MishoMish/Maestro/print/maestro_case/plates/1_ARDUINO_CASE_black.3mf

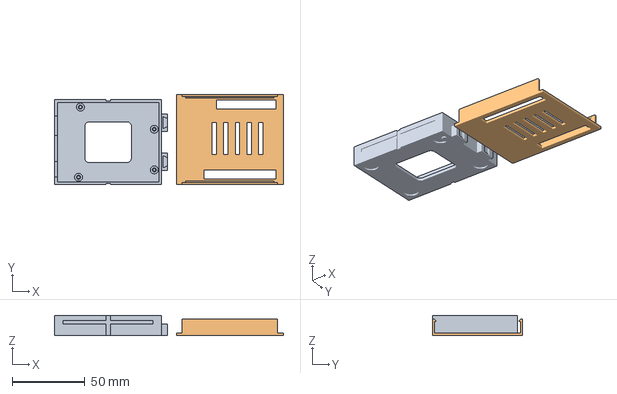
[picture p1: CAD file, 2026-11-06]
print/maestro_case/plates/1_ARDUINO_CASE_black.3mf
157.6 x 62.2 x 14.0 mm
reusable_uno_tray
reusable_uno_lid
