MishoMish/Maestro/print/maestro_case/stl/1_arduino_case/reusable_uno_lid.stl

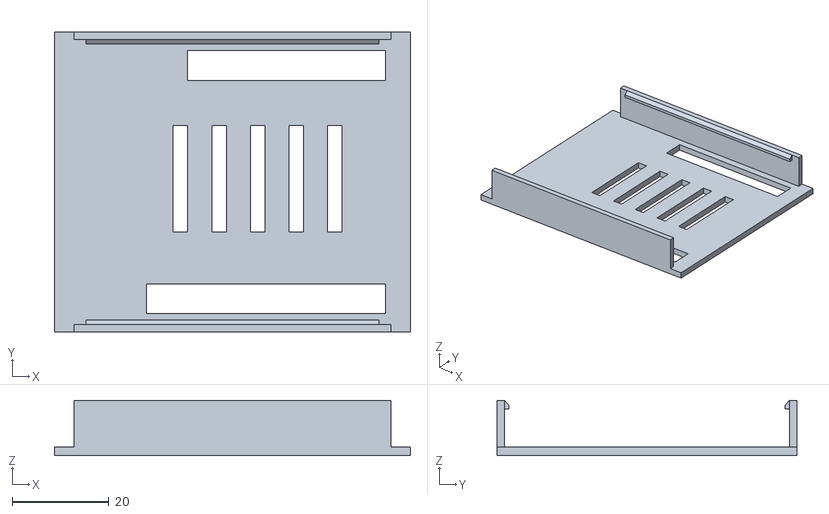
[picture p2: CAD file, 2026-11-06]
print/maestro_case/stl/1_arduino_case/reusable_uno_lid.stl
73.8 x 62.2 x 11.4
