MishoMish/Maestro/print/maestro_case/stl/2_breadboard_case/maestro_keybed_tray.stl

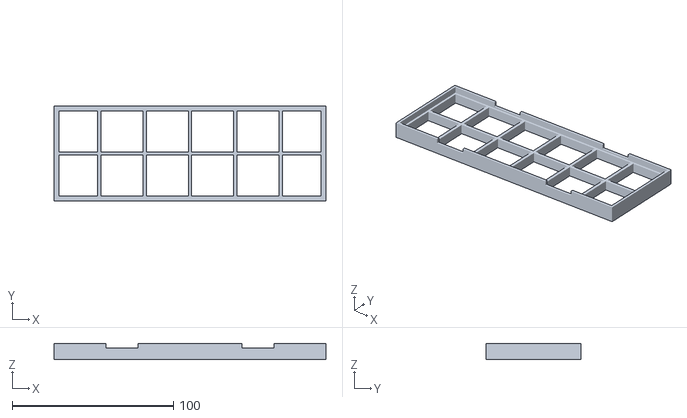
[picture p3: CAD file, 2026-11-06]
print/maestro_case/stl/2_breadboard_case/maestro_keybed_tray.stl
168.8 x 58.8 x 10.2
