MishoMish/Maestro/print/maestro_case/stl/3_maestro/maestro_knob.stl

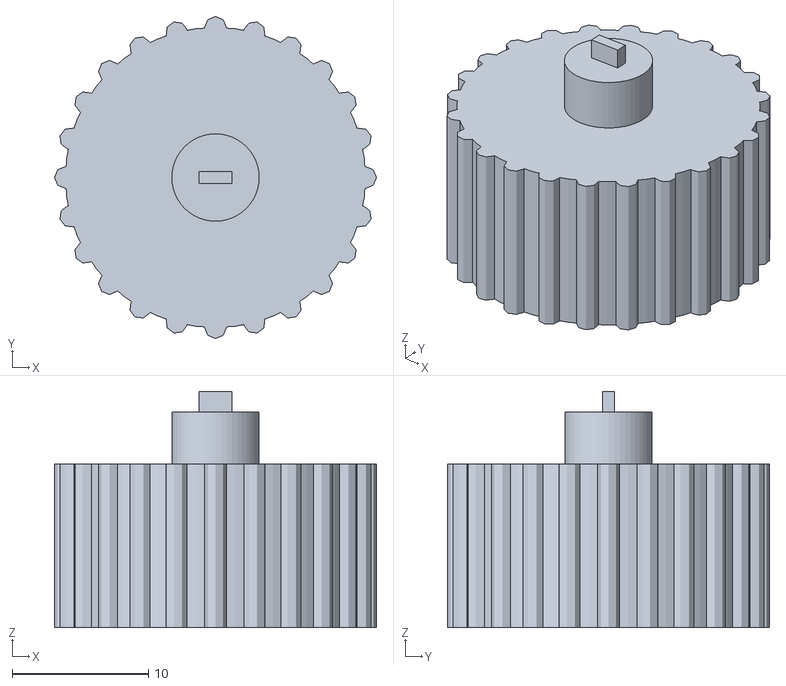
[picture p4: CAD file, 2026-11-06]
print/maestro_case/stl/3_maestro/maestro_knob.stl
23.6 x 23.6 x 17.3
