MishoMish/Maestro/print/maestro_case/plates/3_MAESTRO_BOX_black.3mf

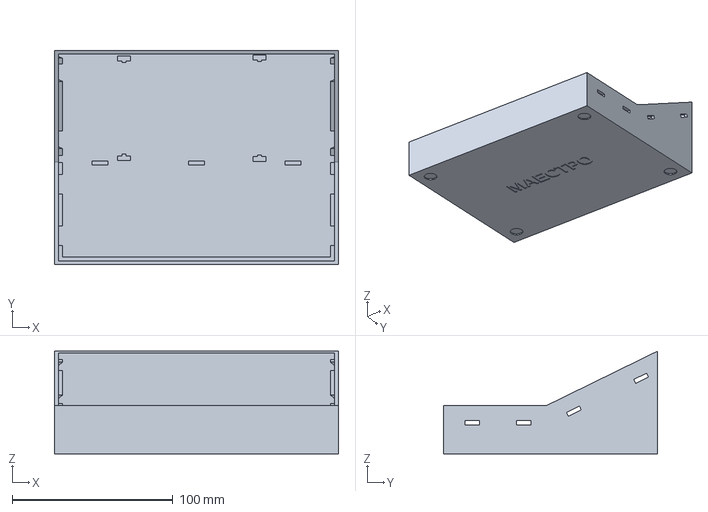
[picture p5: CAD file, 2026-11-06]
print/maestro_case/plates/3_MAESTRO_BOX_black.3mf
176.8 x 133.4 x 64.0 mm
