MishoMish/Maestro/print/maestro_case/stl/1_arduino_case/reusable_uno_tray.stl

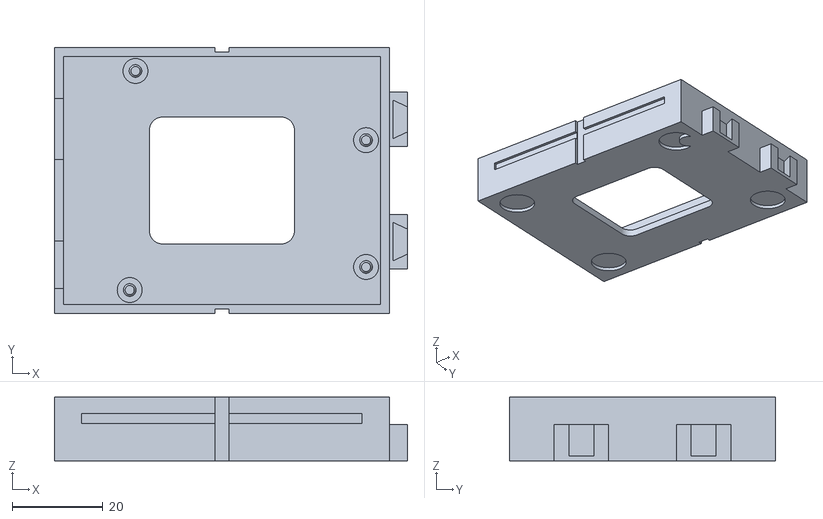
[picture p6: CAD file, 2026-11-06]
print/maestro_case/stl/1_arduino_case/reusable_uno_tray.stl
77.8 x 58.5 x 14.0
