MishoMish/Maestro/print/maestro_case/stl/2_breadboard_case/reusable_bb_tray.stl

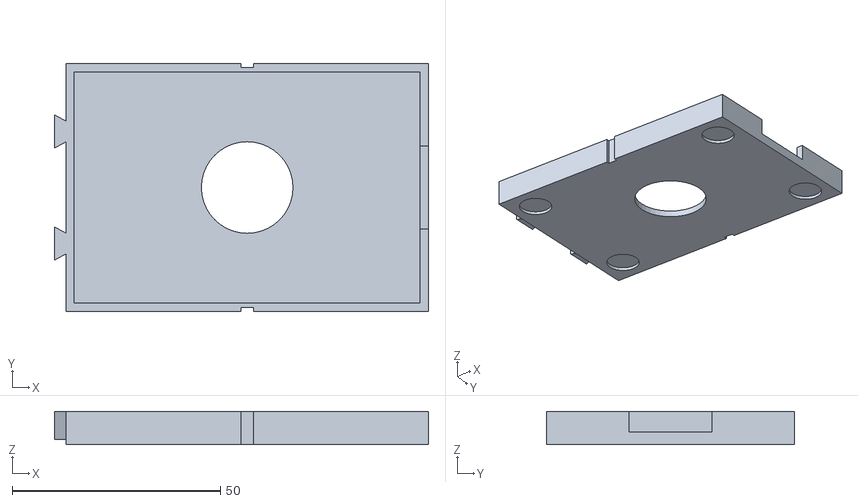
[picture p7: CAD file, 2026-11-06]
print/maestro_case/stl/2_breadboard_case/reusable_bb_tray.stl
89.8 x 59.6 x 8.00
