MishoMish/Maestro/print/maestro_case/stl/3_maestro/maestro_test_key.stl

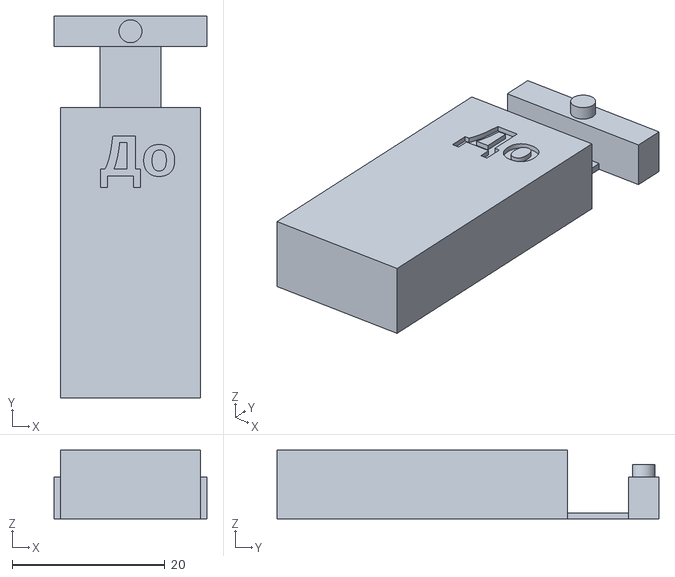
[picture p8: CAD file, 2026-11-06]
print/maestro_case/stl/3_maestro/maestro_test_key.stl
20.0 x 50.0 x 9.00
