MishoMish/Maestro/print/maestro_case/plates/2_BREADBOARD_CASES_black.3mf

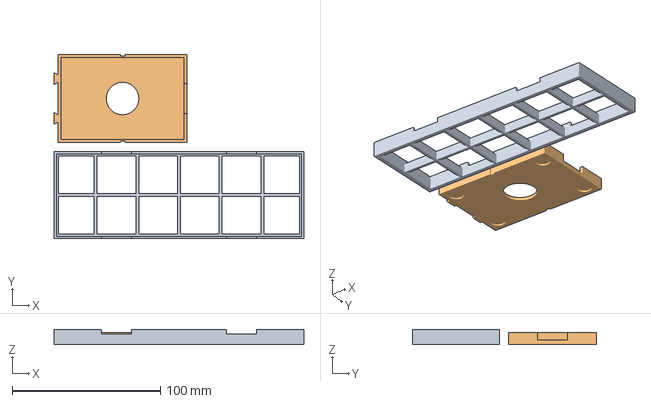
[picture p9: CAD file, 2026-11-06]
print/maestro_case/plates/2_BREADBOARD_CASES_black.3mf
168.8 x 124.4 x 10.2 mm
maestro_keybed_tray
reusable_bb_tray
