MishoMish/Maestro/print/maestro_case/stl/3_maestro/maestro_test_key_plate.stl

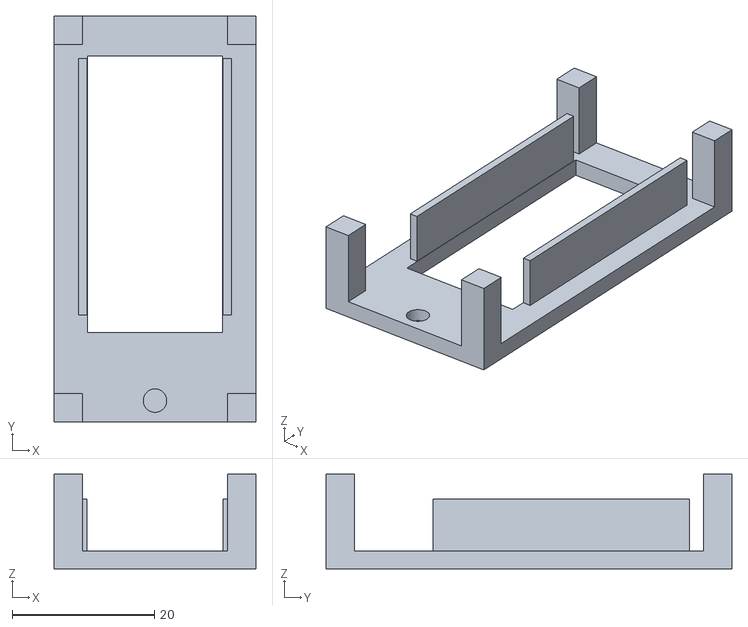
[picture p10: CAD file, 2026-11-06]
print/maestro_case/stl/3_maestro/maestro_test_key_plate.stl
28.3 x 57.0 x 13.3
