MishoMish/Maestro/print/maestro_case/plates/4_MAESTRO_PLATES_black.3mf

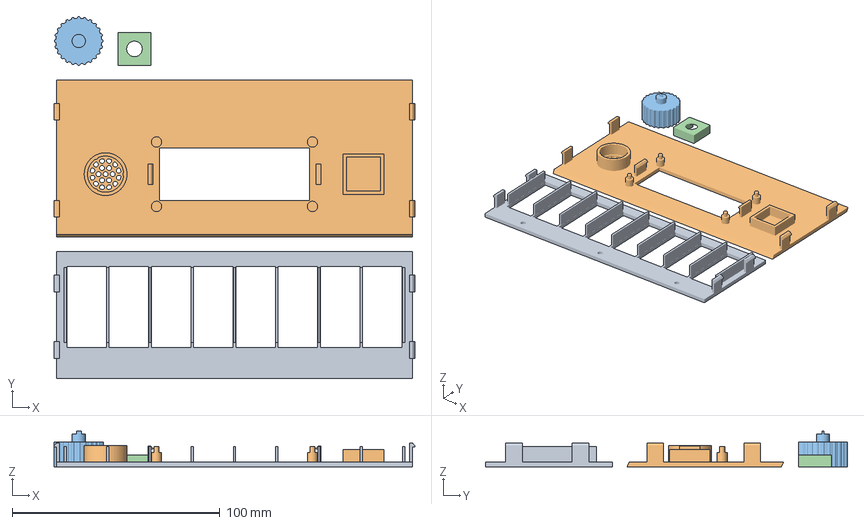
[picture p11: CAD file, 2026-11-06]
print/maestro_case/plates/4_MAESTRO_PLATES_black.3mf
173.4 x 174.1 x 17.3 mm
maestro_deck_plate
maestro_panel
maestro_knob
maestro_pot_holder
