MishoMish/Maestro/print/maestro_case/plates/0_TESTS_black.3mf

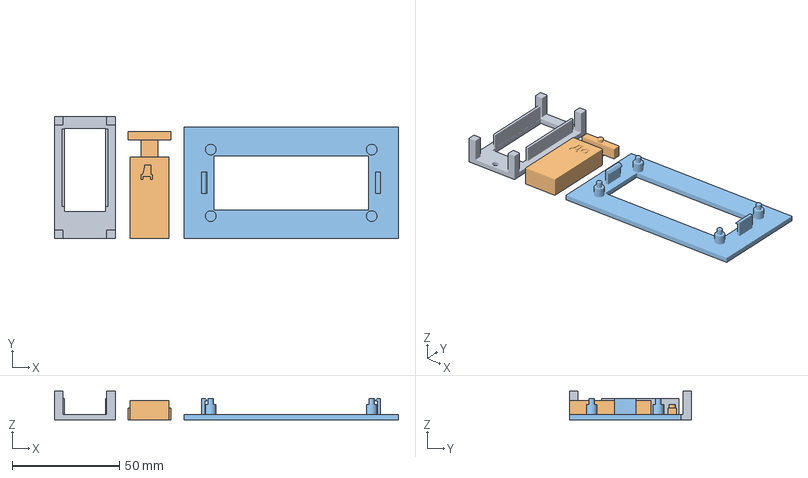
[picture p12: CAD file, 2026-11-06]
print/maestro_case/plates/0_TESTS_black.3mf
160.3 x 57.0 x 13.3 mm
maestro_test_key_plate
maestro_test_key
maestro_test_lcd
