MishoMish/Maestro/print/maestro_case/stl/3_maestro/maestro_key_comb.stl

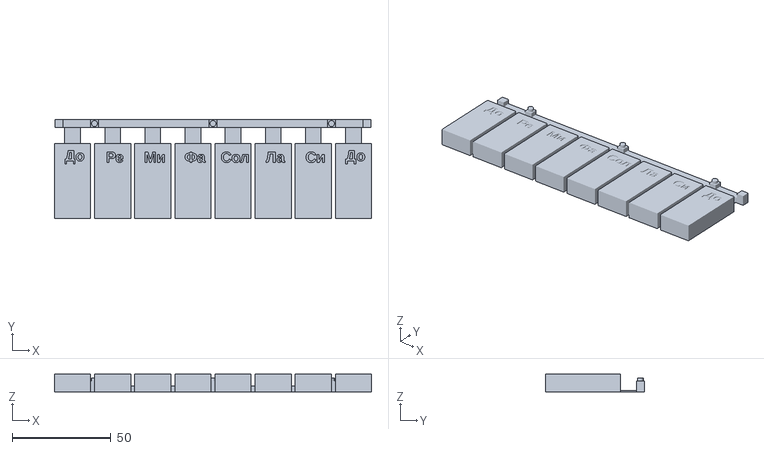
[picture p13: CAD file, 2026-11-06]
print/maestro_case/stl/3_maestro/maestro_key_comb.stl
160.5 x 50.0 x 9.00
