MishoMish/Maestro/print/maestro_case/stl/3_maestro/maestro_panel.stl

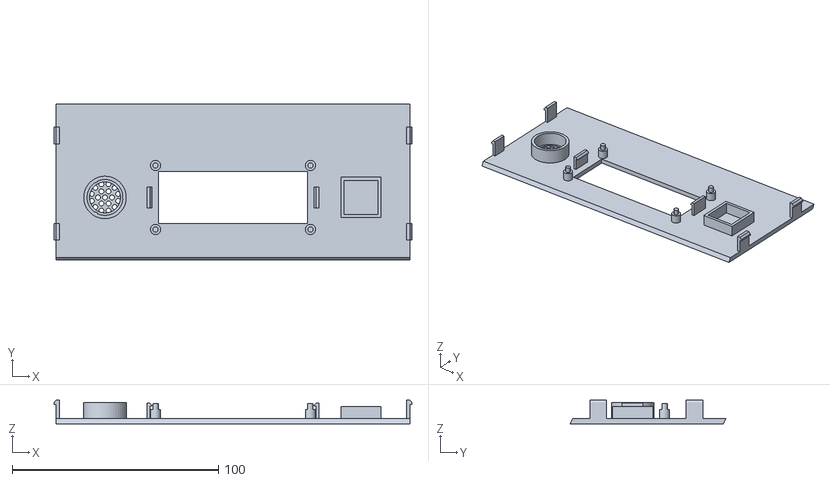
[picture p14: CAD file, 2026-11-06]
print/maestro_case/stl/3_maestro/maestro_panel.stl
173.4 x 75.5 x 11.5
