MishoMish/Maestro/print/maestro_case/stl/3_maestro/maestro_test_lcd.stl

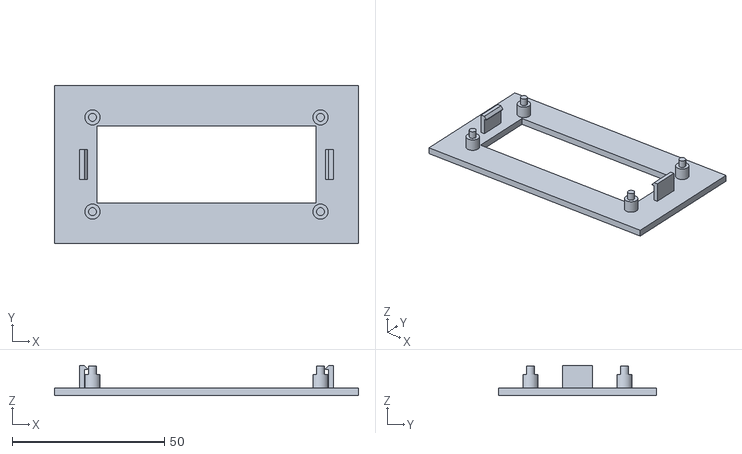
[picture p15: CAD file, 2026-11-06]
print/maestro_case/stl/3_maestro/maestro_test_lcd.stl
100.0 x 52.0 x 10.0
