MishoMish/Maestro/print/maestro_case/stl/3_maestro/maestro_deck_plate.stl

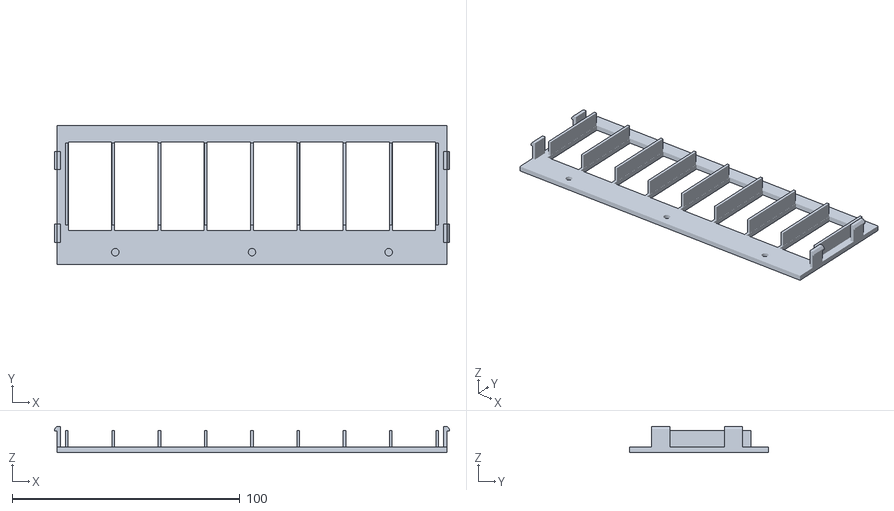
[picture p16: CAD file, 2026-11-06]
print/maestro_case/stl/3_maestro/maestro_deck_plate.stl
173.4 x 61.0 x 11.5
