MishoMish/Maestro/print/maestro_case/stl/3_maestro/maestro_pot_holder.stl

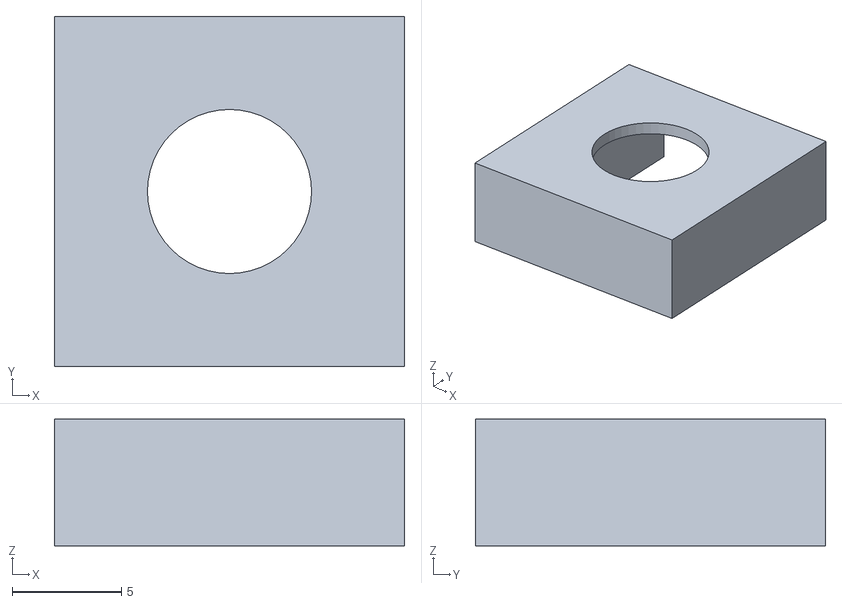
[picture p17: CAD file, 2026-11-06]
print/maestro_case/stl/3_maestro/maestro_pot_holder.stl
16.0 x 16.0 x 5.80
