MishoMish/Maestro/(list of files, cad)

Other CAD files:
print/maestro_case/stl/3_maestro/maestro_box.stl
print/maestro_case/plates/5_MAESTRO_KEYS_white.3mf
