MishoMish/Maestro/print/maestro_case/preview/assembled.png

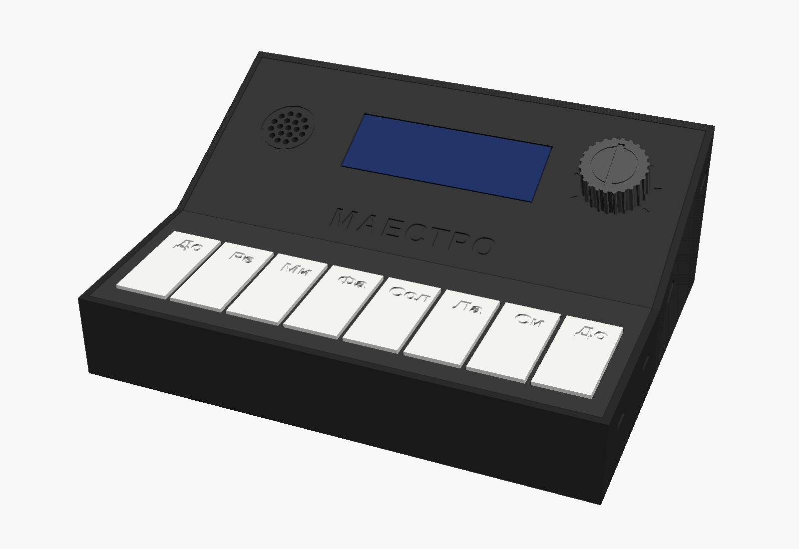
print/maestro_case/preview/assembled.png
