MishoMish/Maestro/print/maestro_case/preview/exploded.png

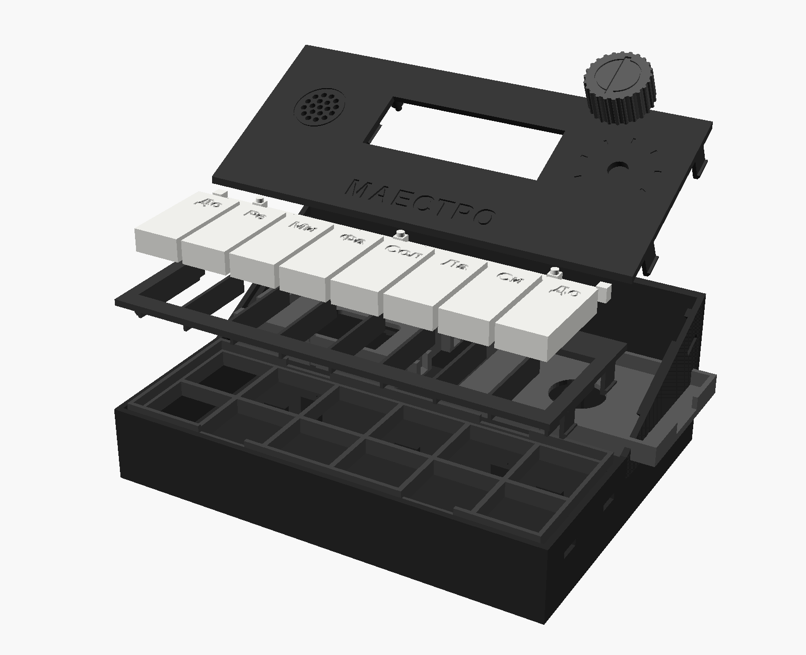
print/maestro_case/preview/exploded.png
