MishoMish/Maestro/print/maestro_case/preview/reusable_trays.png

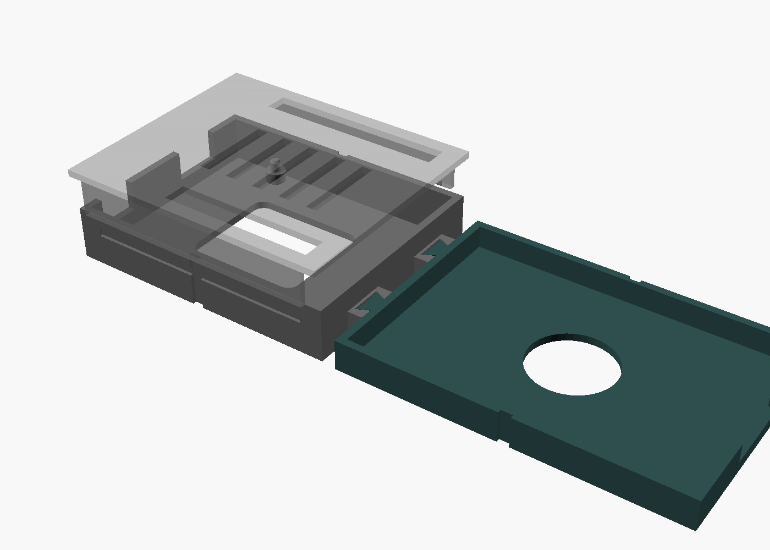
print/maestro_case/preview/reusable_trays.png
