MishoMish/Maestro/(commit log)

2026-11-06 Initial print commit
    [0_TESTS_black.3mf, 1_ARDUINO_CASE_black.3mf, 2_BREADBOARD_CASES_black.3mf, 3_MAESTRO_BOX_black.3mf, 4_MAESTRO_PLATES_black.3mf, 5_MAESTRO_KEYS_white.3mf, maestro.scad, maestro_box.stl]
2026-11-06 Add Maestro game firmware
    Non-blocking state machine with Light only, Sound only, Light + sound, Ear
    and Free play, plus lives, Easy mode, rhythm judging, records in EEPROM and
    a hardware test build. Rules are in DECISIONS.md.
    [config.h, input.cpp, input.h, main.cpp, output.cpp, output.h]
2026-11-06 Add simulated device and test suite
    Runs the real firmware in simavr with the case's wiring emulated. Covers
    menus, keys, knob, all modes, scoring, records and whole-piece wins.
2026-11-07 Add maestro command and VS Code tasks
    One command with a menu for checking the computer, uploading, testing the
    wiring, working on songs and running tests. Song errors now name the line
    and say how to fix it.
2026-11-07 Add the build guide and fix a resistor placement
    Generates a step-by-step wiring guide from a wiring list, which is checked
    electrically on every build. The check found that the case guide put two
    ladder resistor legs in the same hole, so each now starts in row h and ends
    in row i.
2026-11-07 Add an on-chip self-test and wire the simulator from the build guide
    ./maestro selftest runs the real game on the Uno's own processor with a
    scripted player, checks pins, ADC, EEPROM and timers, and puts the game back.
    Every simulated test now runs on a device wired from the guide's wiring list,
    and deliberately wrong wiring is shown to break it.
    [device.py, harness.c, input.cpp, main.cpp, output.cpp]
